Zmathh/SAE-KART/README.md

# SAE-KART 

Supervision d'un Kart



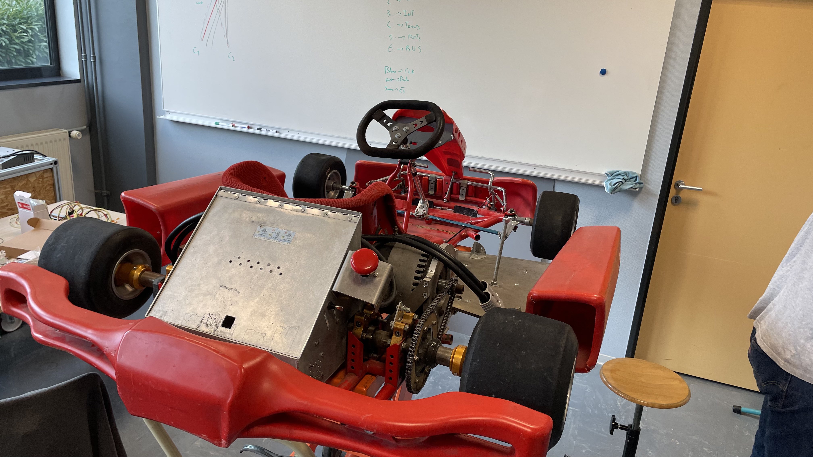
[picture p1: images/Kart.jpg]
Kart


## Programme ESP32

### Roadmap

- Intégrer les modules testés et validés individuelement dans un même programme principal (main)

- Utilisation d'un module I2C pour la communication UART du module GPS.

- Fix les modules

### Avancée

| Module | Test | Notes |
| --- | --- | -|
| MAIN ESP32 | ✅ |Terminé fonctionnel |
| Dual Core | ✅ |Terminé fonctionnel (1 loop/coeurs (2) ) |
| GPS | ✅ |Terminé fonctionnel |
| Module Lora | ✅ |Terminé fonctionnel |
| écran | ✅ |Terminé fonctionnel |
| Accel/frein | ✅ |Terminé fonctionnel |
| Shift register| ✅ |Terminé fonctionnel |
| Capteur temperature|🟨 |Manque capteur temp moteur |
| I2C TO UART | ✅ |Terminé fonctionnel |
| Capteur fréquence| ✅  |Terminé fonctionnel |

## SAE-KART LoRa
Simple KiCad design for an Arduino compatible RN2483 (or RN2903) LoRaWA suited for our Project.

Fork of the original [jpmeyers/RN2483shield](https://github.com/jpmeijers/RN2483shield).

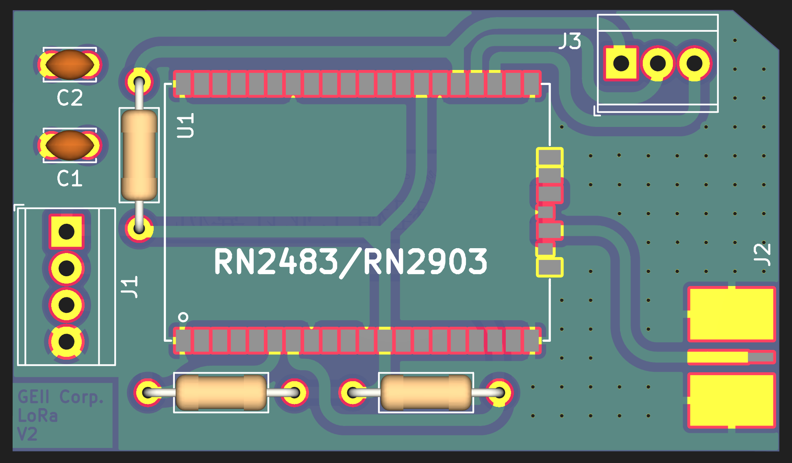
[picture p2: module_LoRa_Kicad/images/top_rev1.png]
top layout

***Top board view***

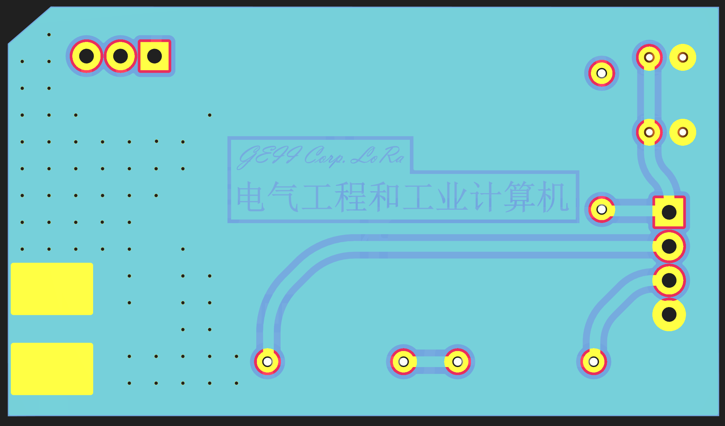
[picture p3: module_LoRa_Kicad/images/bottom_rev1.png]
bottom layout

***Bottom board view***

Adjusted to:

 * ignore the 433MHz antenna trace (868MHz only),

### Required Parts for PCB

 * 3× 10k resistors,
 * 1× SMA 868MHz antenna,
 * 1x RN2483 (or RN2903)

### Setting up

WIP
-debug possible

### Schematic

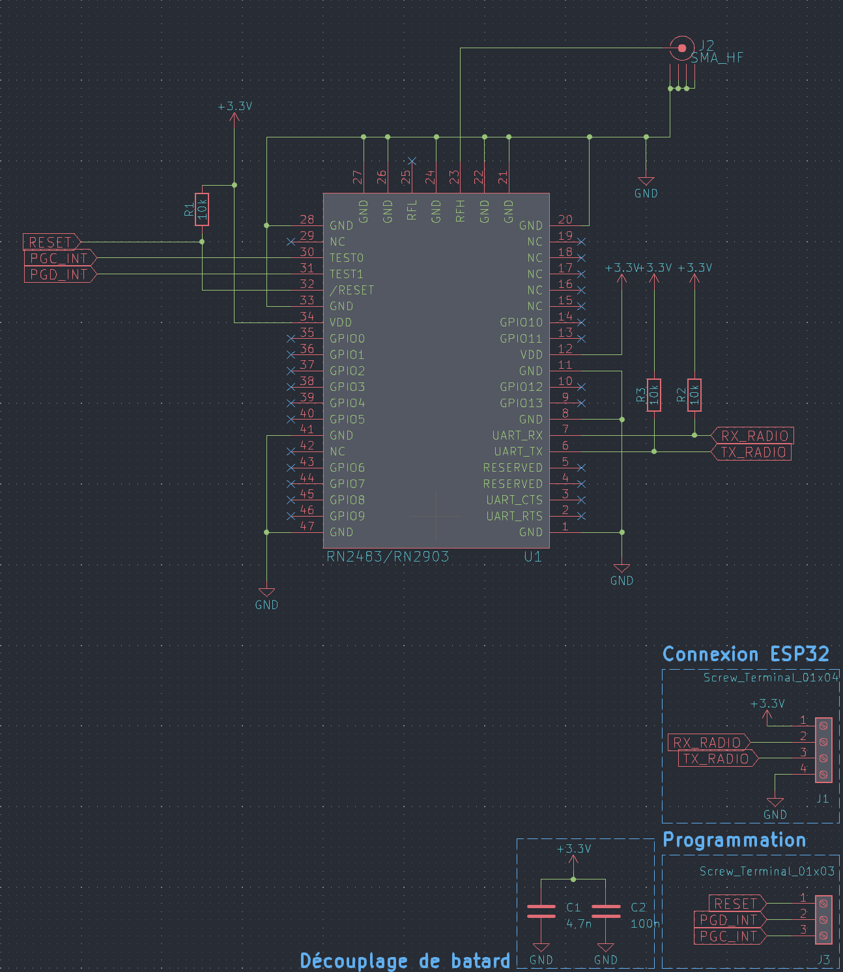
[picture p4: module_LoRa_Kicad/images/Schematic.png]
Schematic

***Schematic***

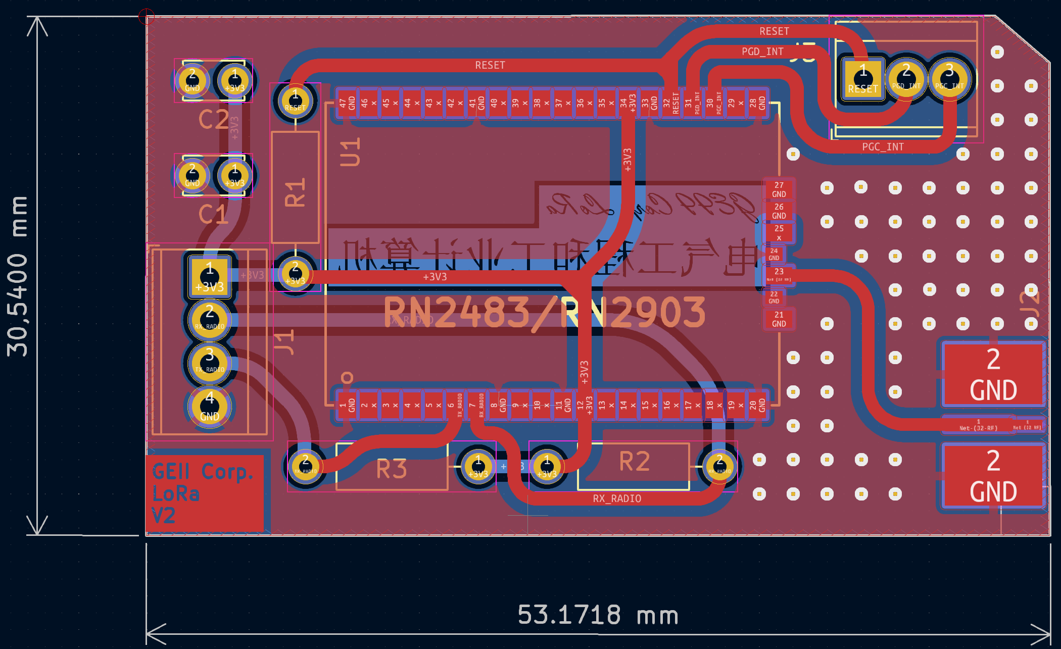
[picture p5: module_LoRa_Kicad/images/PCB.png]
PCB

***PCB***

## Solidworks Case
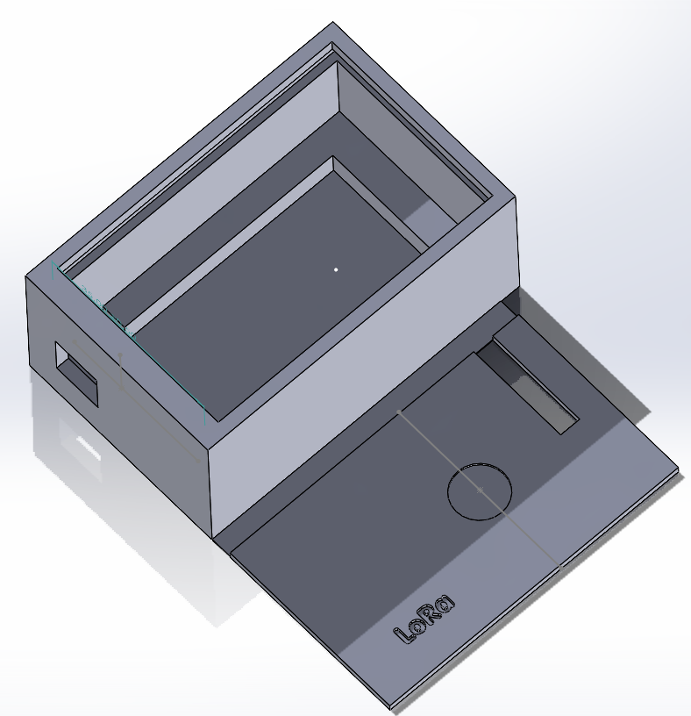
[picture p6: solidworks/images/Solidworks_view.png]
Solidworks

***Solidworks view***

### RF Impedance Analyser Results

>(R +jX) - Calibrated with 50ohms

First_vers
> The first version was a bit off, because we didn't follow the [LoRa Module Datasheet](https://ww1.microchip.com/downloads/aemDocuments/documents/OTH/ProductDocuments/DataSheets/RN2483-Low-Power-Long-Range-LoRa-Technology-Transceiver-Module-DS50002346F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), where we have application information for better transmission.
Tiny holes are for [via stitching](https://www.altium.com/documentation/altium-designer/via-stitching-via-shielding-pcb) 

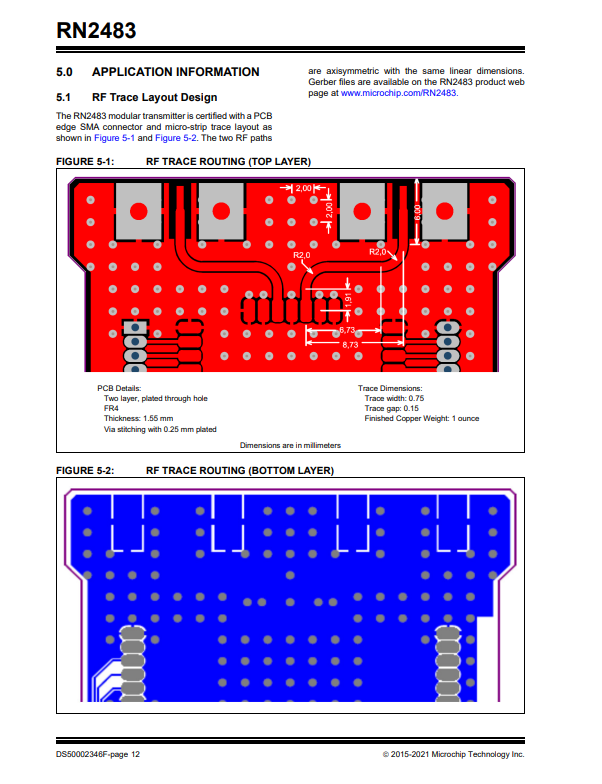
[picture p7: images/Datasheet.png]
Datasheet


***[Datasheet P.12](https://ww1.microchip.com/downloads/aemDocuments/documents/OTH/ProductDocuments/DataSheets/RN2483-Low-Power-Long-Range-LoRa-Technology-Transceiver-Module-DS50002346F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)***

Second_vers
In the end after testing we are getting better results, better signal strenght and range. So we are certainly closer for a better impedance, but it could be better as the Analyser retrieved us with not perfect transmision Impedence (29.5 +j*92.3) 
## Final result

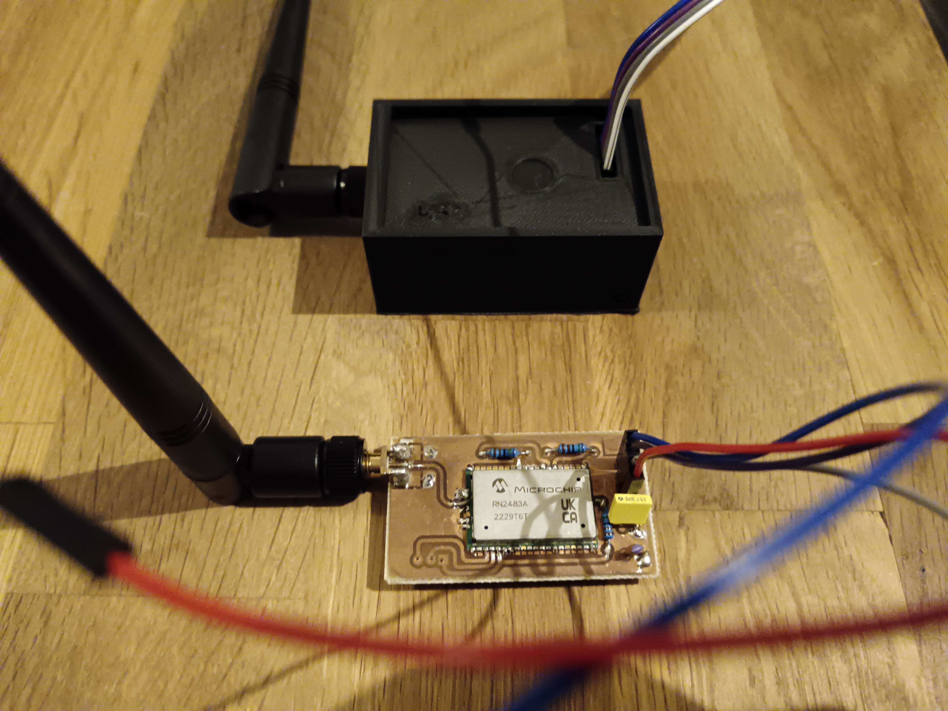
[picture p8: images/finalprod1.jpg]
Final result

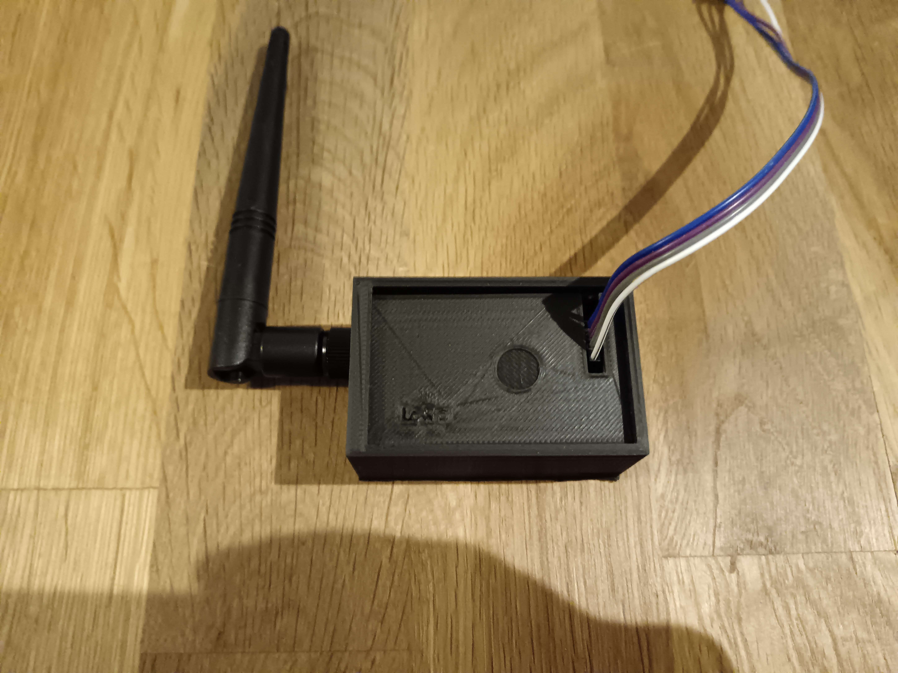
[picture p9: images/finalprod2.jpg]
Final result

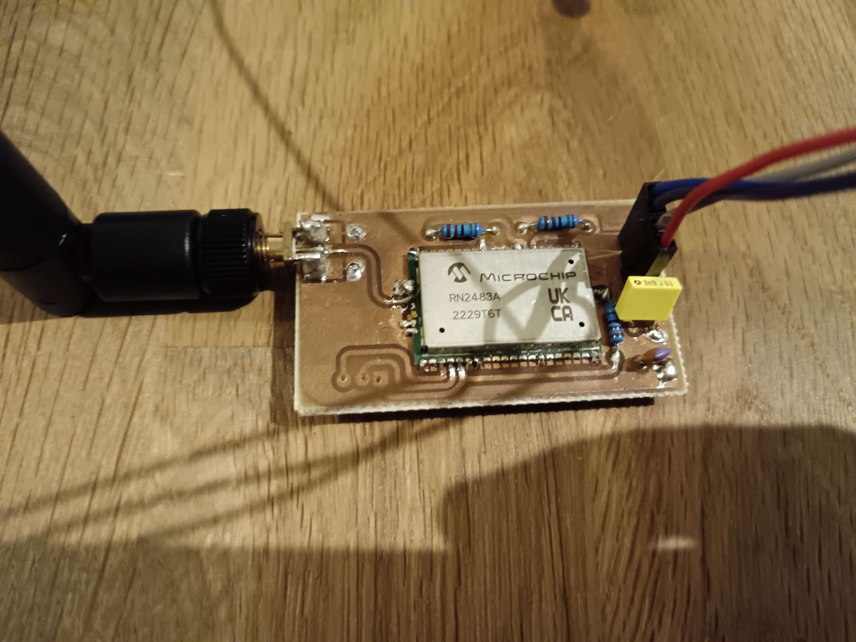
[picture p10: images/top_view.jpg]

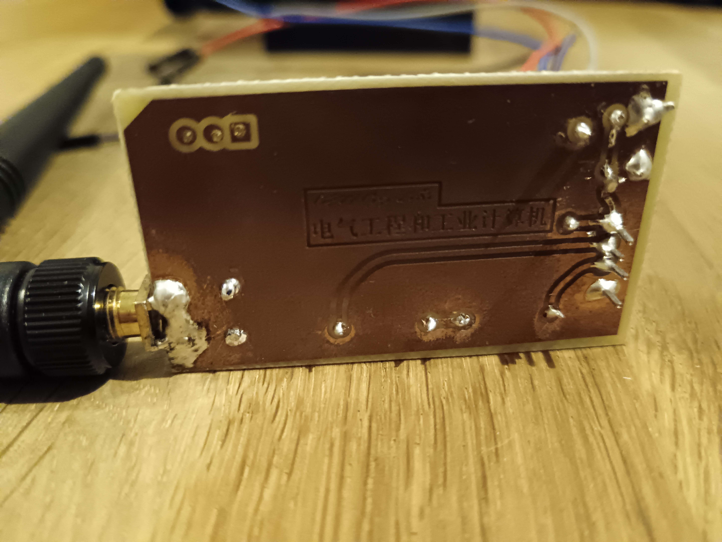
[picture p11: images/bot_view.jpg]

***Final result***
## Processing 

Despite the use of an LCD arduino screen, we wanted to add a better gauge interface, more customizable so we tried to use processing.
A first sketch code has been written, using an raspberry pi with a raspberry 7" screen.
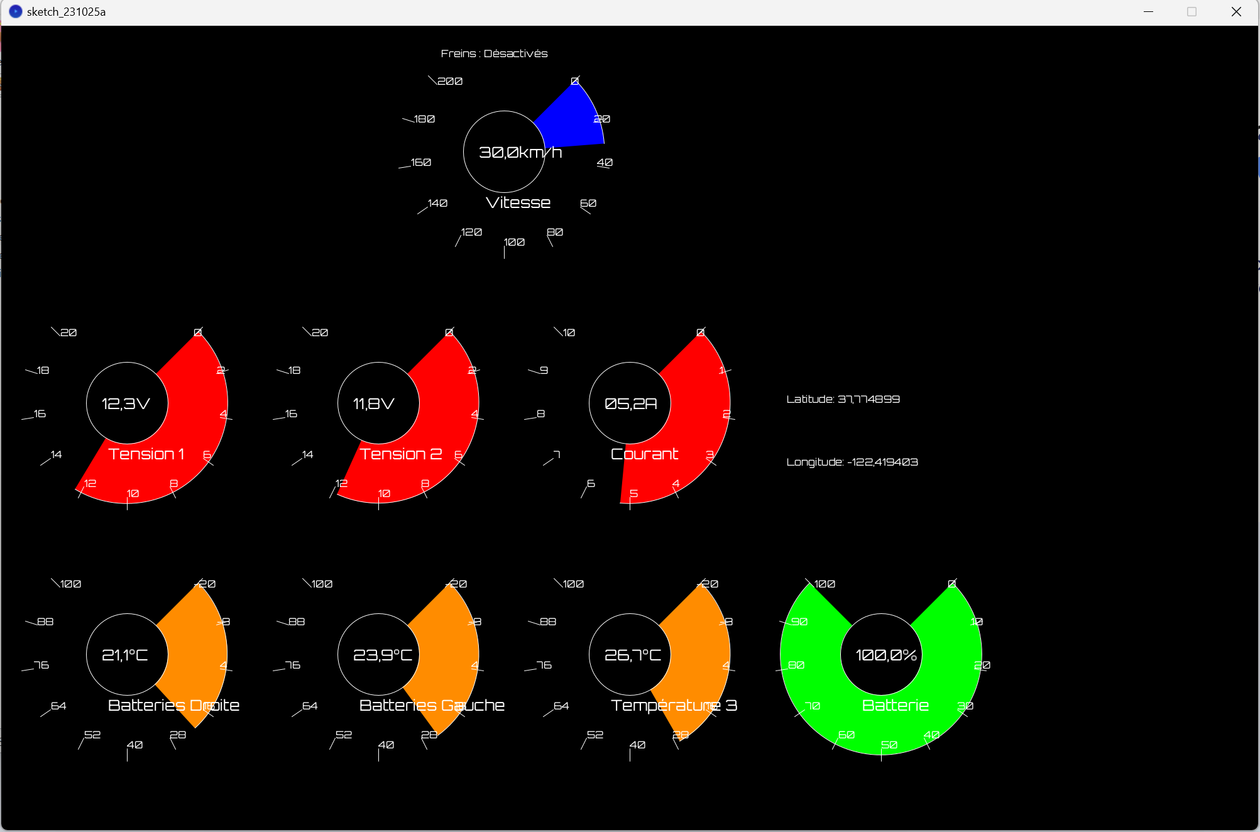
[picture p12: images/processing_interface.png]
Processing interface
