Zmathh/SAE-KART/DataSheet/esp32_pinOut.png

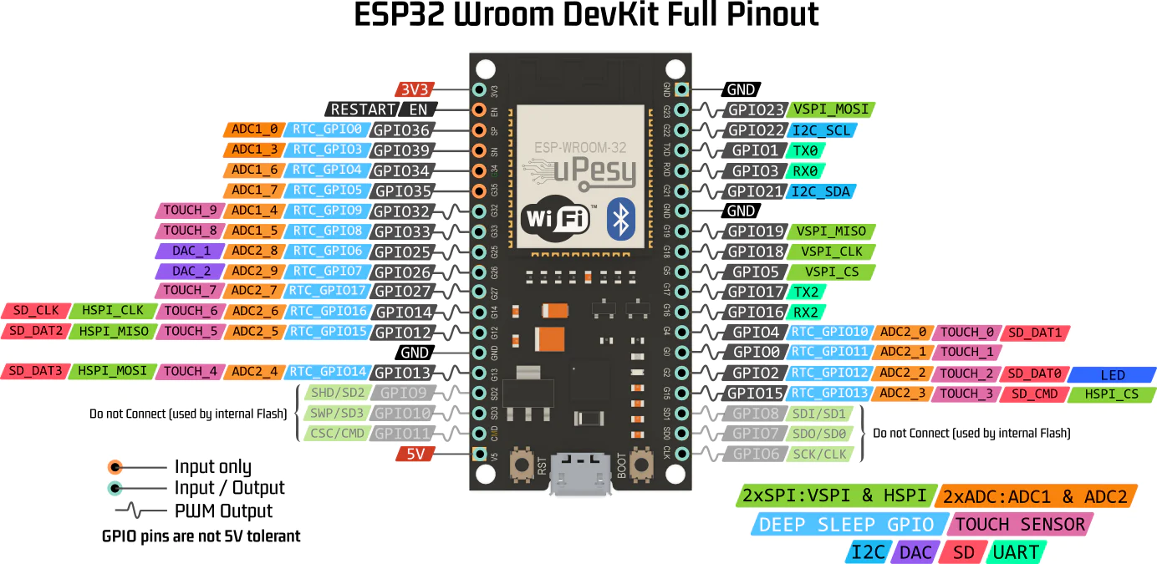
DataSheet/esp32_pinOut.png
