Zmathh/SAE-KART/solidworks/boitier LoRa.SLDPRT

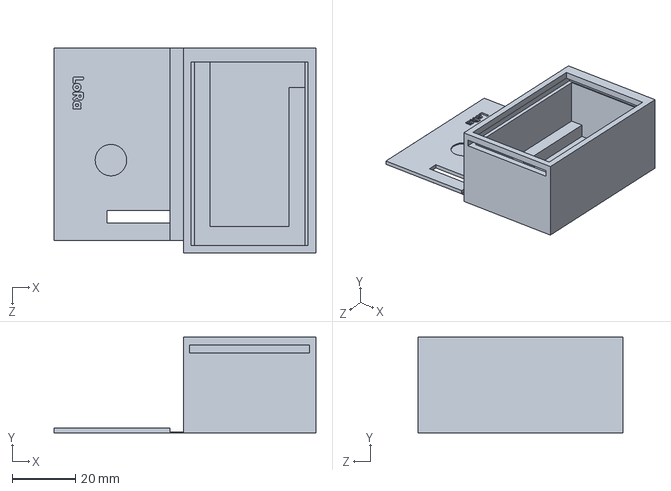
[picture p14: CAD file, 2023-11-27]
solidworks/boitier LoRa.SLDPRT
82.9 x 30.2 x 65.0 mm
