Zmathh/SAE-KART/module_LoRa_Kicad/pdf/RN2483shield-B_Cu.pdf

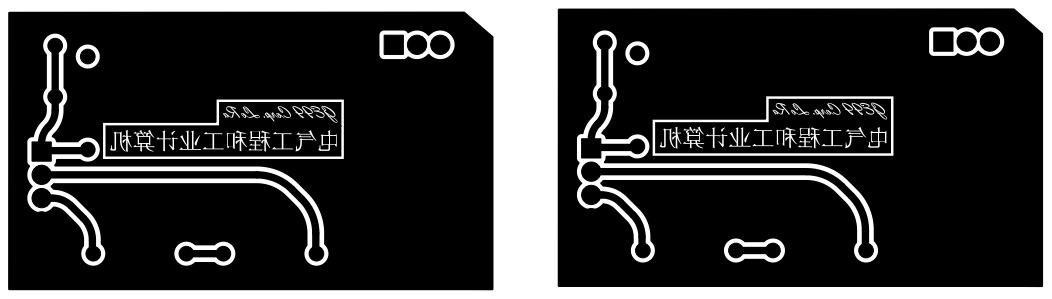
[picture p15: page 1]
