Zmathh/SAE-KART/module_LoRa_Kicad/pdf/RN2483shield-F_Cu.pdf

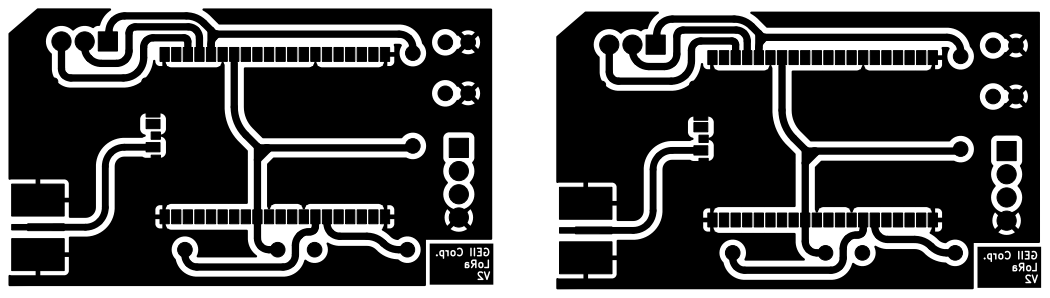
[picture p16: page 1]
