Zmathh/SAE-KART/module_LoRa_Kicad/RN2483shield.kicad_pcb

## KiCad design module_LoRa_Kicad/RN2483shield.kicad_pcb (2023-11-27)

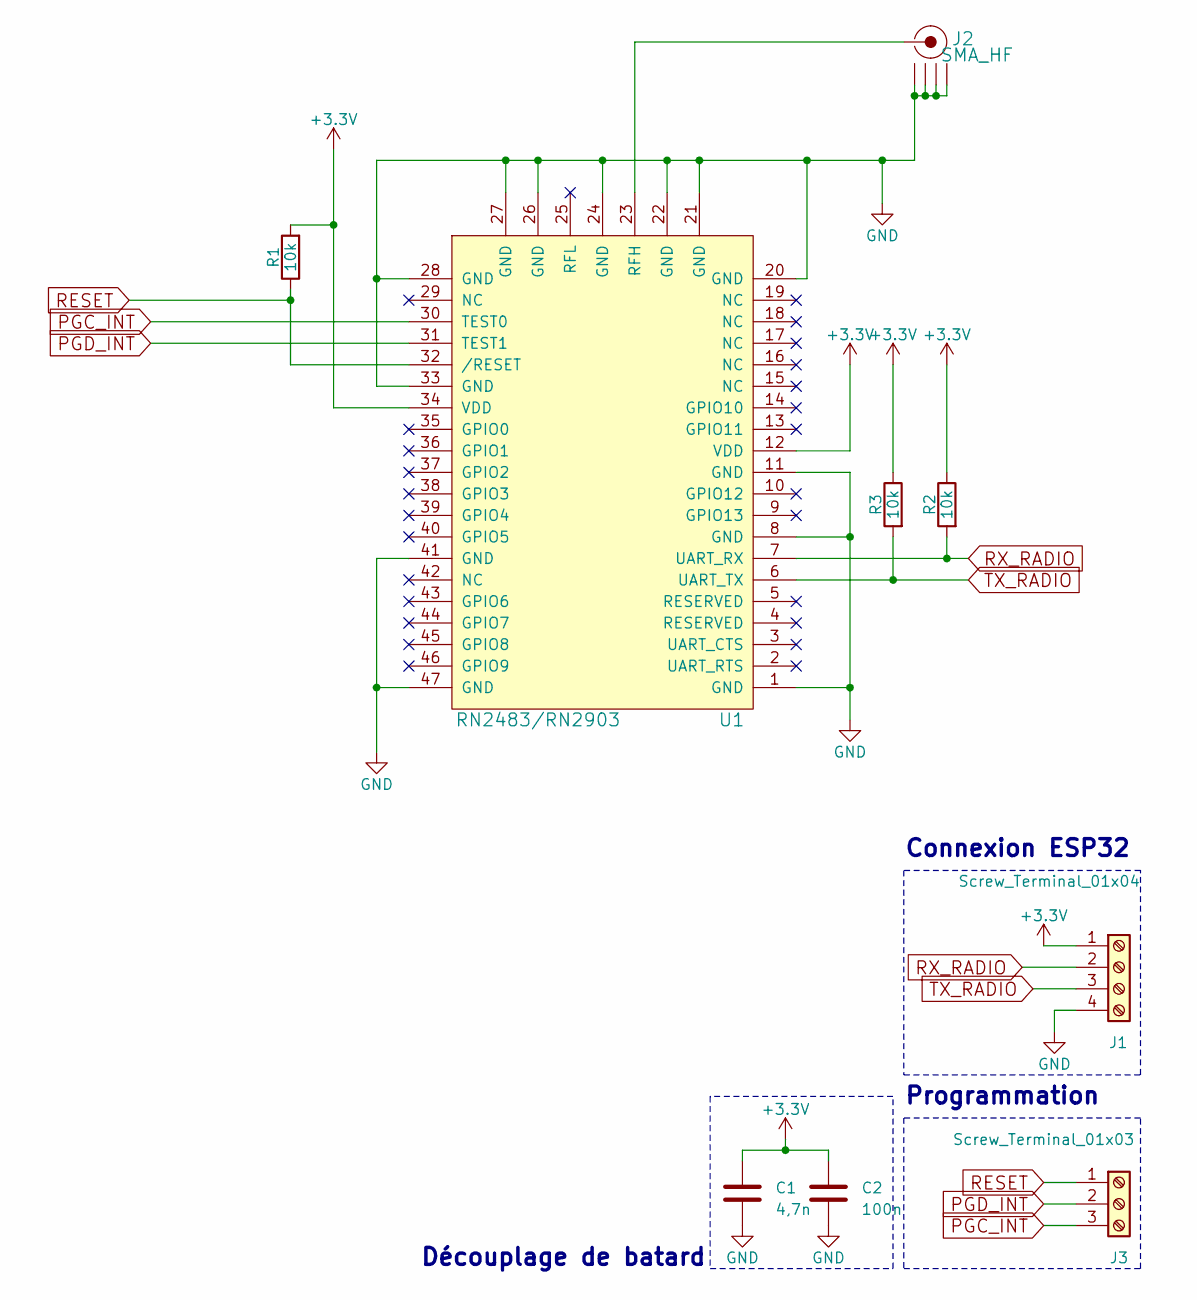
[picture p17: schematic RN2483shield.kicad_sch]

Parts:
C1: 4,7n; C_Disc_D3.4mm_W2.1mm_P2.50mm
C2: 100n; C_Disc_D3.4mm_W2.1mm_P2.50mm
J1: Screw_Terminal_01x04; TerminalBlock_TE_282834-4_1x04_P2.54mm_Horizontal
J2: SMA_HF; multi-rf-sma-ufl
J3: Screw_Terminal_01x03; TerminalBlock_TE_282834-3_1x03_P2.54mm_Horizontal
R1, R2, R3: 10k; R_Axial_DIN0207_L6.3mm_D2.5mm_P10.16mm_Horizontal
U1: RN2483/RN2903; RN2483

Connections:
+3V3: C1.1, C2.1, J1.1, R1.2, R2.1, R3.1, U1.12 (VDD), U1.34 (VDD)
GND: C1.2, C2.2, J1.4, J2.2 (GND1), U1.1 (GND), U1.8 (GND), U1.11 (GND), U1.20 (GND), U1.21 (GND), U1.22 (GND), U1.24 (GND), U1.26 (GND), U1.27 (GND), U1.28 (GND), U1.33 (GND), U1.41 (GND), U1.47 (GND)
unnamed: J2.1 (RF), U1.23 (RFH)
PGC_INT: J3.3, U1.30 (TEST0)
PGD_INT: J3.2, U1.31 (TEST1)
RESET: J3.1, R1.1, U1.32 (/RESET)
RX_RADIO: J1.2, R2.2, U1.7 (UART_RX)
TX_RADIO: J1.3, R3.2, U1.6 (UART_TX)

Notes on the sheet:
Connexion ESP32
Programmation
Découplage de batard

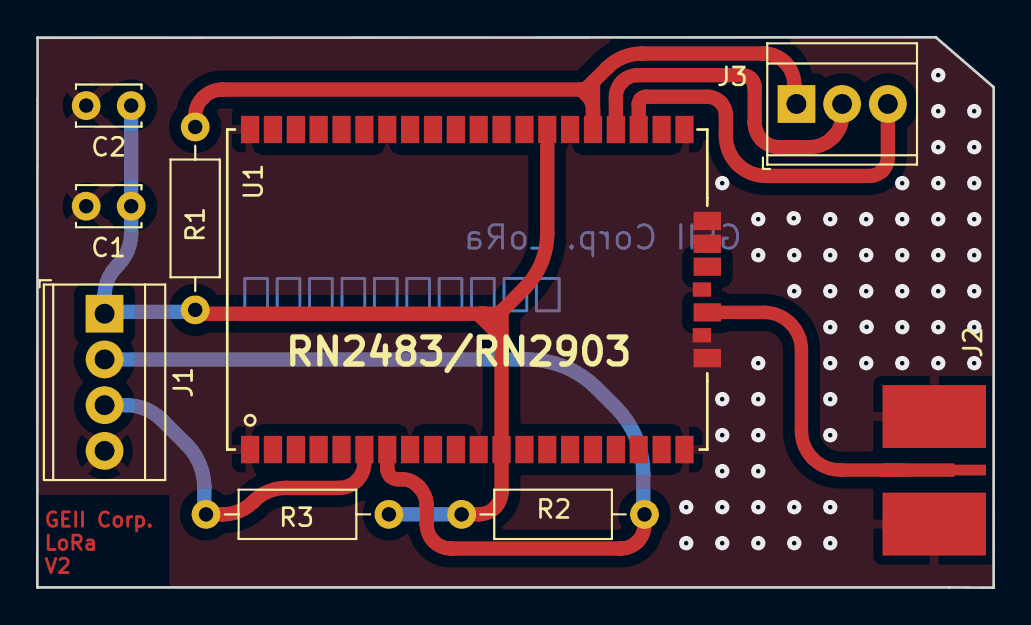
[picture p18: board RN2483shield.kicad_pcb from above]

Board: 2 copper layers, 53.1 x 30.6 mm, 9 parts (0 on the bottom side), 8 nets.
