Zmathh/SAE-KART/ESP32Code/LM74/LM74_V2.h

#ifndef LM74_V2_H
#define LM74_V2_H

#include "Arduino.h"

class LM74 {
    public:
        LM74(shiftReg &shiftRegister);

        void begin();

        float read(int selecteur);

    private:
        shiftReg &shiftRegister;
};

#endif
