Zmathh/SAE-KART/(commit log)

2024-01-30 adding ESP32Code
2024-01-30 Ajout des petit code
2024-01-30 Template pour les comaintaire
2024-01-30 dedoublage arduino.h
2024-01-30 define des varriable
2024-01-30 Ajout des biblioteques en local
2024-01-31 GPS NO MORE BROKEN
    [ESP32Code.ino, GPS.cpp, GPS.h]
2024-01-31 FIcher h de freq
2024-01-31 Fix librairy for project
    [CONFIG_H.h, SoftwareSerial.h]
2024-01-31 BuildPath + 1ere version GPS non valide
    [partitions.csv]
2024-02-03 je degage le temp
    [partitions.csv]
2024-02-03 fix build path "build" parent folder
    [ESP32Code.ino]
2024-02-05 fix lecture temps main
    [CONFIG_H.h, ESP32Code.ino]
2024-02-09 changement tentative prog freq + gps en i2c
2024-03-19 Mise a jour des pins
2024-03-20 résolution interruptions dans programme écran ?
2024-03-21 fix pins pour uwire
    [CONFIG_H.h]
2024-03-26 calibration capteur temp avec nouvelle lib
2024-03-26 analog read batterie 12V
2024-03-26 Modification du code pour fonctionnement peut etre des boutons
2024-03-26 Commentaire du timer non utiliser
